haydenwoodhead/rp2040-devboard/rpi2040-devboard/production/bom.csv

Designator | Footprint | Quantity | Value | LCSC Part #
C1, C2 | 0603 | 2 | 10uF | C96446
C10, C11, C16, C22, C3, C4, C5, C6, C7, C8, C9 | 0603 | 11 | 0.1uF | C14663
C12, C13 | 0603 | 2 | 1uF | C128624
C14, C15 | 0603 | 2 | 15pF | C1644
D2 | 0603 | 1 | RED LED | C2286
F1 | 1206 | 1 | Polyfuse, 2A | C6165195
J1 | USB_C_Receptacle_HRO_TYPE-C-31-M-12 | 1 | USB_C_Receptacle_USB2.0_16P | C165948
J2 | PinHeader_1x03_P2.54mm_Vertical | 1 | SWD
J3 | PinHeader_2x08_P2.54mm_Vertical | 1 | GPIO
LED1, LED10, LED11, LED12, LED13, LED14, LED2, LED3, LED4, LED5, LED6, LED7, LED8, LED9 | LED-SMD_4P-L1.6-W1.5_XL-1615RGBC-WS2812B-1 | 14 | XL-1615RGBC-WS2812B | C5349954
R1, R2 | 0603 | 2 | 5.1k | C23186
R3 | 0603 | 1 | 680 | C23228
R4, R5 | 0603 | 2 | 27 | C2770847
R6, R7 | 0603 | 2 | 1k | C22548
R8 | 0603 | 1 | 510 | C23193
SW1 | SW_SPST_TS-1088-xR020 | 1 | RESET | C720477
SW2 | SW_SPST_TS-1088-xR020 | 1 | BOOT | C720477
SW3 | SW-SMD_4P-L5.1-W5.1-P3.70-LS6.5-TL_H1.5 | 1 | USER | C318884
TP1 | TestPoint_Pad_D1.5mm | 1 | VBUS
TP2 | TestPoint_Pad_D1.5mm | 1 | 3v3
TP3 | TestPoint_Pad_D1.5mm | 1 | 1v1
TP4 | TestPoint_Pad_D1.5mm | 1 | GND
U1 | QFN-56-1EP_7x7mm_P0.4mm_EP3.2x3.2mm | 1 | RP2040 | C2040
U2 | SOT-23-5 | 1 | AP2112K-3.3 | C51118
U3 | SOIC-8_5.3x5.3mm_P1.27mm | 1 | W25Q128JVSIQ | C113767
X1 | Crystal_SMD_3225-4Pin_3.2x2.5mm | 1 | 12MHz | C20625731
