haydenwoodhead/rp2040-devboard/rpi2040-devboard/rpi2040-devboard.csv

Reference | Qty | Value | DNP | Exclude from BOM | Exclude from Board | Exclude from Simulation | Exclude from Position Files | Manufacturer | MPN
1v1 | 1 | 1v1 |  |  |  |  | ${EXCLUDE_FROM_POS_FILES}
3v3 | 1 | 3v3 |  |  |  |  | ${EXCLUDE_FROM_POS_FILES}
BOOTSEL1 | 1 | BOOTSEL |  |  |  |  | ${EXCLUDE_FROM_POS_FILES} | XUNPU | TS-1088-AR02016
BUZZER1 | 1 | KMTG1203 |  |  |  |  | ${EXCLUDE_FROM_POS_FILES} | KINGSTATE(志丰电子) | KMTG1203
C1,C2 | 2 | 10uF |  |  |  |  | ${EXCLUDE_FROM_POS_FILES} | Samsung Electro-Mechanics | CL10A106MA8NRNC
C3,C4,C5,C6,C7,C8,C9,C10,C11,C16,C22 | 11 | 0.1uF |  |  |  |  | ${EXCLUDE_FROM_POS_FILES} | YAGEO | CC0603KRX7R9BB104
C12,C13 | 2 | 1uF |  |  |  |  | ${EXCLUDE_FROM_POS_FILES} | YAGEO | CC0603KRX5R9BB105
C14,C15 | 2 | 15pF |  |  |  |  | ${EXCLUDE_FROM_POS_FILES} | Samsung Electro-Mechanics | CL10C150JB8NNNC
D2 | 1 | RED LED |  |  |  |  | ${EXCLUDE_FROM_POS_FILES} | Hubei KENTO Elec | KT-0603R
F1 | 1 | Polyfuse, 2A |  |  |  |  | ${EXCLUDE_FROM_POS_FILES} | BORN | SMD1206-200/06N
GND1 | 1 | GND |  |  |  |  | ${EXCLUDE_FROM_POS_FILES}
GPIO1 | 1 | GPIO |  |  |  |  | ${EXCLUDE_FROM_POS_FILES}
J1 | 1 | USB_C_Receptacle_USB2.0_16P |  |  |  |  | ${EXCLUDE_FROM_POS_FILES} | Korean Hroparts Elec | TYPE-C-31-M-12
LED1,LED2,LED3,LED4,LED5,LED6,LED7,LED8,LED9,LED10 | 10 | XL-1615RGBC-WS2812B |  |  |  |  | ${EXCLUDE_FROM_POS_FILES} | XINGLIGHT(成兴光) | XL-1615RGBC-2812B
R1,R2 | 2 | 5.1k |  |  |  |  | ${EXCLUDE_FROM_POS_FILES} | UNI-ROYAL(Uniroyal Elec) | 0603WAF5101T5E
R3 | 1 | 680 |  |  |  |  | ${EXCLUDE_FROM_POS_FILES} | UNI-ROYAL(Uniroyal Elec) | 0603WAF6800T5E
R4,R5 | 2 | 27 |  |  |  |  | ${EXCLUDE_FROM_POS_FILES} | UNI-ROYAL(Uniroyal Elec) | CQ03WAF270JT5E
R6,R7,R9 | 3 | 1k |  |  |  |  | ${EXCLUDE_FROM_POS_FILES} | YAGEO | RC0603FR-071KL
R8 | 1 | 510 |  |  |  |  | ${EXCLUDE_FROM_POS_FILES} | UNI-ROYAL(Uniroyal Elec) | 0603WAF5100T5E
RESET1 | 1 | RESET |  |  |  |  | ${EXCLUDE_FROM_POS_FILES} | XUNPU | TS-1088-AR02016
SWD1 | 1 | SWD |  |  |  |  | ${EXCLUDE_FROM_POS_FILES}
U1 | 1 | RP2040 |  |  |  |  | ${EXCLUDE_FROM_POS_FILES} | Raspberry Pi | RP2040
U2 | 1 | AP2112K-3.3 |  |  |  |  | ${EXCLUDE_FROM_POS_FILES} | Diodes Incorporated | AP2112K-3.3TRG1
U3 | 1 | W25Q128JVSIQ |  |  |  |  | ${EXCLUDE_FROM_POS_FILES} | Winbond Elec | W25Q128JVSIQ
USR1 | 1 | TS-1187A-B-A-B |  |  |  |  | ${EXCLUDE_FROM_POS_FILES} | XKB Connection(中国星坤) | TS-1187A-B-A-B
VBUS1 | 1 | VBUS |  |  |  |  | ${EXCLUDE_FROM_POS_FILES}
X1 | 1 | 12MHz |  |  |  |  | ${EXCLUDE_FROM_POS_FILES} | Abracon LLC | ABM8-272-T3
