haydenwoodhead/rp2040-devboard/rpi2040-devboard/rpi2040-devboard.kicad_pcb

## KiCad design rpi2040-devboard/rpi2040-devboard.kicad_pcb (2026-10-08)

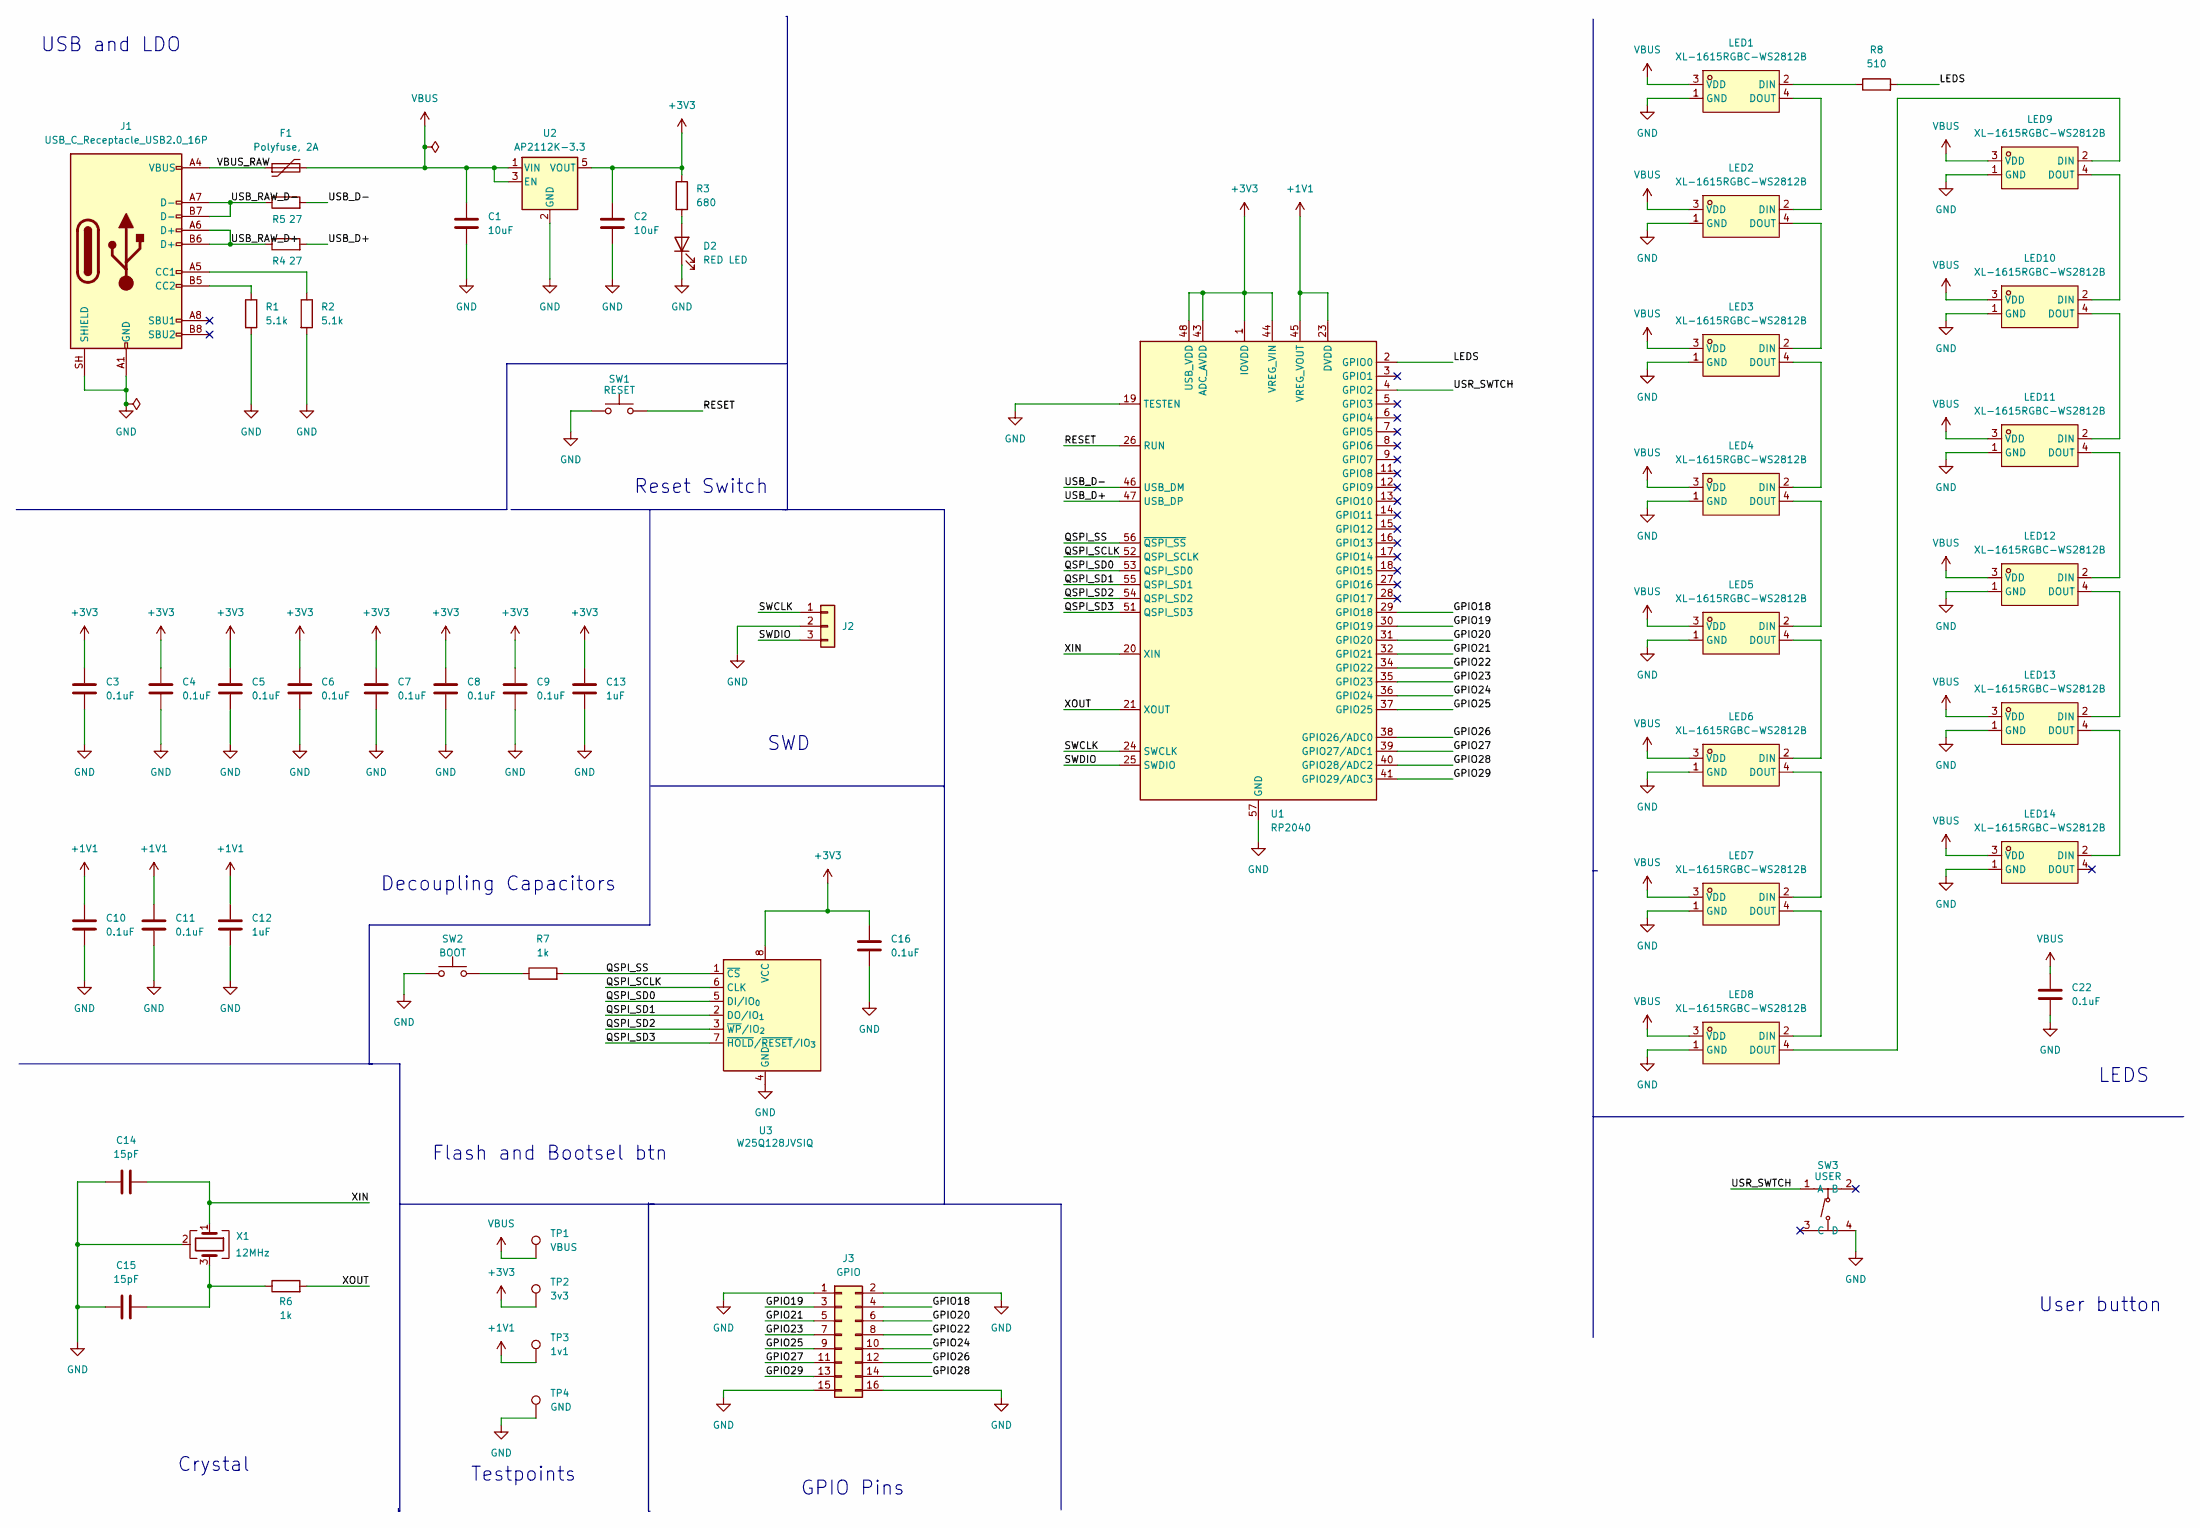
[picture p1: schematic rpi2040-devboard.kicad_sch, RP2040 Dev Board]

Parts:
C1, C2: 10uF; C_0603_1608Metric; MPN CL10A106MA8NRNC; LCSC C96446
C3, C4, C5, C6, C7, C8, C9, C10, C11, C16, C22: 0.1uF; C_0603_1608Metric; MPN CC0603KRX7R9BB104; LCSC C14663
C12, C13: 1uF; C_0603_1608Metric; MPN CC0603KRX5R9BB105; LCSC C128624
C14, C15: 15pF; C_0603_1608Metric; MPN CL10C150JB8NNNC; LCSC C1644
D2: RED LED; LED_0603_1608Metric; MPN KT-0603R; LCSC C2286
F1: Polyfuse, 2A; Fuse_1206_3216Metric; MPN SMD1206-200/06N; LCSC C6165195
J1: USB_C_Receptacle_USB2.0_16P; USB_C_Receptacle_HRO_TYPE-C-31-M-12; MPN TYPE-C-31-M-12; LCSC C165948
J2: SWD; PinHeader_1x03_P2.54mm_Vertical
J3: GPIO; PinHeader_2x08_P2.54mm_Vertical
LED1, LED2, LED3, LED4, LED5, LED6, LED7, LED8, LED9, LED10, LED11, LED12, LED13, LED14: XL-1615RGBC-WS2812B; LED-SMD_4P-L1.6-W1.5_XL-1615RGBC-WS2812B-1; MPN XL-1615RGBC-2812B; LCSC Part C5349954
R1, R2: 5.1k; R_0603_1608Metric; MPN 0603WAF5101T5E; LCSC C23186
R3: 680; R_0603_1608Metric; MPN 0603WAF6800T5E; LCSC C23228
R4, R5: 27; R_0603_1608Metric; MPN CQ03WAF270JT5E; LCSC C2770847
R6, R7: 1k; R_0603_1608Metric; MPN RC0603FR-071KL; LCSC C22548
R8: 510; R_0603_1608Metric; MPN 0603WAF5100T5E; LCSC C23193
SW1: RESET; SW_SPST_TS-1088-xR020; MPN TS-1088-AR02016; LCSC C720477
SW2: BOOT; SW_SPST_TS-1088-xR020; MPN TS-1088-AR02016; LCSC C720477
SW3: USER; SW-SMD_4P-L5.1-W5.1-P3.70-LS6.5-TL_H1.5; MPN TS-1187A-B-A-B; LCSC Part C318884
TP1: VBUS; TestPoint_Pad_D1.5mm
TP2: 3v3; TestPoint_Pad_D1.5mm
TP3: 1v1; TestPoint_Pad_D1.5mm
TP4: GND; TestPoint_Pad_D1.5mm
U1: RP2040; QFN-56-1EP_7x7mm_P0.4mm_EP3.2x3.2mm; MPN RP2040; LCSC C2040
U2: AP2112K-3.3; SOT-23-5; MPN AP2112K-3.3TRG1; LCSC C51118
U3: W25Q128JVSIQ; SOIC-8_5.3x5.3mm_P1.27mm; MPN W25Q128JVSIQ; LCSC C113767
X1: 12MHz; Crystal_SMD_3225-4Pin_3.2x2.5mm; tolerance 30ppm; part_uid RP-01G8X7-GS352B; LCSC C20625731

Connections:
+1V1: C10.1, C11.1, C12.1, TP3.1 (1_1), U1.23 (DVDD), U1.45 (VREG_VOUT), U1.50 (DVDD)
+3V3: C2.1, C3.1, C4.1, C5.1, C6.1, C7.1, C8.1, C9.1, C13.1, C16.1, R3.1, TP2.1 (1_1), U1.1 (IOVDD), U1.10 (IOVDD), U1.22 (IOVDD), U1.33 (IOVDD), U1.42 (IOVDD), U1.43 (ADC_AVDD), U1.44 (VREG_VIN), U1.48 (USB_VDD), U1.49 (IOVDD), U2.5 (VOUT), U3.8 (VCC)
/GPIO18: J3.4, U1.29 (GPIO18)
/GPIO19: J3.3, U1.30 (GPIO19)
/GPIO20: J3.6, U1.31 (GPIO20)
/GPIO21: J3.5, U1.32 (GPIO21)
/GPIO22: J3.8, U1.34 (GPIO22)
/GPIO23: J3.7, U1.35 (GPIO23)
/GPIO24: J3.10, U1.36 (GPIO24)
/GPIO25: J3.9, U1.37 (GPIO25)
/GPIO26: J3.12, U1.38 (GPIO26/ADC0)
/GPIO27: J3.11, U1.39 (GPIO27/ADC1)
/GPIO28: J3.14, U1.40 (GPIO28/ADC2)
/GPIO29: J3.13, U1.41 (GPIO29/ADC3)
/LEDS: R8.2, U1.2 (GPIO0)
/QSPI_SCLK: U1.52 (QSPI_SCLK), U3.6 (CLK)
/QSPI_SD0: U1.53 (QSPI_SD0), U3.5 (DI/IO_{0})
/QSPI_SD1: U1.55 (QSPI_SD1), U3.2 (DO/IO_{1})
/QSPI_SD2: U1.54 (QSPI_SD2), U3.3 (~WP/IO_{2})
/QSPI_SD3: U1.51 (QSPI_SD3), U3.7 (~HOLD/~RESET/IO_{3})
/QSPI_SS: R7.2, U1.56 (~QSPI_SS), U3.1 (~CS)
/RESET: SW1.2, U1.26 (RUN)
/SWCLK: J2.1, U1.24 (SWCLK)
/SWDIO: J2.3, U1.25 (SWDIO)
/USB_D+: R4.2, U1.47 (USB_DP)
/USB_D-: R5.2, U1.46 (USB_DM)
/USB_RAW_D+: J1.A6 (D+), J1.B6 (D+), R4.1
/USB_RAW_D-: J1.A7 (D-), J1.B7 (D-), R5.1
/USR_SWTCH: SW3.1 (A), U1.4 (GPIO2)
/VBUS_RAW: F1.1, J1.A4 (VBUS), J1.A9 (VBUS), J1.B4 (VBUS), J1.B9 (VBUS)
/XIN: C14.2, U1.20 (XIN), X1.1
/XOUT: R6.2, U1.21 (XOUT)
GND: C1.2, C2.2, C3.2, C4.2, C5.2, C6.2, C7.2, C8.2, C9.2, C10.2, C11.2, C12.2, C13.2, C14.1, C15.1, C16.2, C22.2, D2.1 (K), J1.A1 (GND), J1.A12 (GND), J1.B1 (GND), J1.B12 (GND), J1.SH (SHIELD), J2.2, J3.1, J3.2, J3.15, J3.16, LED1.1 (GND), LED2.1 (GND), LED3.1 (GND), LED4.1 (GND), LED5.1 (GND), LED6.1 (GND), LED7.1 (GND), LED8.1 (GND), LED9.1 (GND), LED10.1 (GND), LED11.1 (GND), LED12.1 (GND), LED13.1 (GND), LED14.1 (GND), R1.2, R2.2, SW1.1, SW2.1, SW3.4 (D), TP4.1 (1_1), U1.19 (TESTEN), U1.57 (GND), U2.2 (GND), U3.4 (GND), X1.2 (G), X1.4 (G)
unnamed: C15.2, R6.1, X1.3
unnamed: D2.2 (A), R3.2
unnamed: J1.A5 (CC1), R2.1
unnamed: J1.B5 (CC2), R1.1
unnamed: LED1.2 (DIN), R8.1
unnamed: LED1.4 (DOUT), LED2.2 (DIN)
unnamed: LED2.4 (DOUT), LED3.2 (DIN)
unnamed: LED3.4 (DOUT), LED4.2 (DIN)
unnamed: LED4.4 (DOUT), LED5.2 (DIN)
unnamed: LED5.4 (DOUT), LED6.2 (DIN)
unnamed: LED6.4 (DOUT), LED7.2 (DIN)
unnamed: LED7.4 (DOUT), LED8.2 (DIN)
unnamed: LED8.4 (DOUT), LED9.2 (DIN)
unnamed: LED9.4 (DOUT), LED10.2 (DIN)
unnamed: LED10.4 (DOUT), LED11.2 (DIN)
unnamed: LED11.4 (DOUT), LED12.2 (DIN)
unnamed: LED12.4 (DOUT), LED13.2 (DIN)
unnamed: LED13.4 (DOUT), LED14.2 (DIN)
unnamed: R7.1, SW2.2
VBUS: C1.1, C22.1, F1.2, LED1.3 (VDD), LED2.3 (VDD), LED3.3 (VDD), LED4.3 (VDD), LED5.3 (VDD), LED6.3 (VDD), LED7.3 (VDD), LED8.3 (VDD), LED9.3 (VDD), LED10.3 (VDD), LED11.3 (VDD), LED12.3 (VDD), LED13.3 (VDD), LED14.3 (VDD), TP1.1 (1_1), U2.1 (VIN), U2.3 (EN)

Notes on the sheet:
LEDS
User button
GPIO Pins
USB and LDO
SWD
Testpoints
Flash and Bootsel btn
Decoupling Capacitors
Crystal
Reset Switch

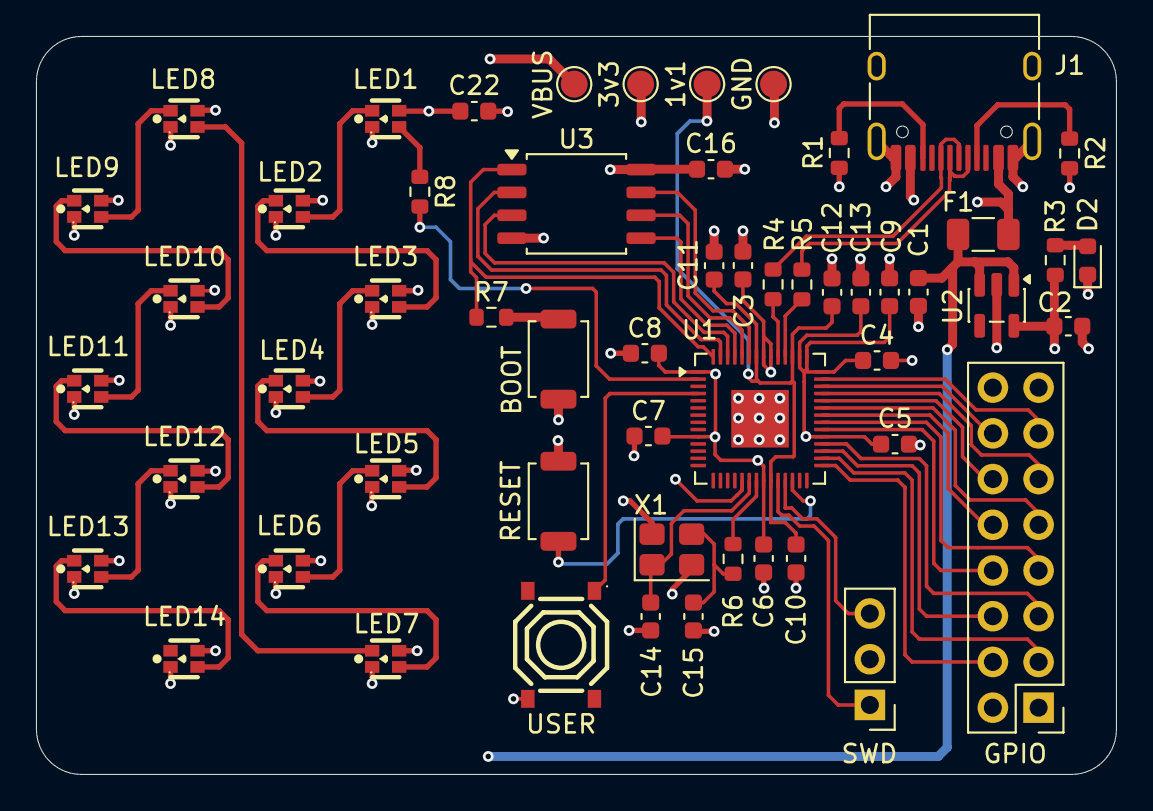
[picture p2: board rpi2040-devboard.kicad_pcb from above]

Board: 4 copper layers, 60.0 x 41.0 mm, 55 parts (0 on the bottom side), 53 nets.
