haydenwoodhead/rp2040-devboard/(commit log)

2026-08-26 Basic USB C, 3v3 and decoupling caps
    [rpi2040-devboard.kicad_pcb, rpi2040-devboard.kicad_sch]
2026-08-27 Add crystal and usb resistors
    [rpi2040-devboard.kicad_sch]
2026-08-30 LEDs, speakers, GPIO and test points
    [rpi2040-devboard.kicad_sch]
2026-08-31 Change symbols and footprints. ERC good!
    [rpi2040-devboard.kicad_sch]
2026-09-03 Get ready for routing
    [rpi2040-devboard.kicad_pcb, rpi2040-devboard.kicad_sch]
2026-09-14 Main components placed + board outline
    [rpi2040-devboard.kicad_pcb, rpi2040-devboard.kicad_sch]
2026-09-22 Rough placement
    [rpi2040-devboard.kicad_pcb]
2026-09-23 Vias placed
    [rpi2040-devboard.kicad_pcb]
2026-09-29 USB routed and some other stuff
    [rpi2040-devboard.kicad_pcb]
2026-10-03 A pretty crap start at routing leds
    [rpi2040-devboard.kicad_pcb, rpi2040-devboard.kicad_sch]
2026-10-03 Basically everything but gpio
    [rpi2040-devboard.kicad_pcb]
2026-10-03 Shift gpio around a little for better routing
    [rpi2040-devboard.kicad_sch]
2026-10-04 Trying to route gpio pins
    [rpi2040-devboard.kicad_pcb]
2026-10-04 Almost finished me thinks
    [rpi2040-devboard.kicad_pcb, rpi2040-devboard.kicad_sch]
2026-10-06 Final pass for v1 me thinks
    [rpi2040-devboard.kicad_pcb, rpi2040-devboard.kicad_sch]
2026-10-07 Change parts to in stock ones
    [rpi2040-devboard.kicad_pcb, rpi2040-devboard.kicad_sch]
2026-10-07 Fix drifted identifiers
    [rpi2040-devboard.kicad_pcb, rpi2040-devboard.kicad_sch]
2026-10-08 No buzzer only leds
    [rpi2040-devboard.kicad_pcb, rpi2040-devboard.kicad_sch]
2026-11-08 Reddit stuff
    [rpi2040-devboard.kicad_sch]
2026-11-08 Bom list etc
    [bom.csv, designators.csv, positions.csv, rpi2040-devboard.csv]
